clarkewayne/FHIRM-TPM-2.0-technical-documents/files/Assemble_miniature microscope.STEP

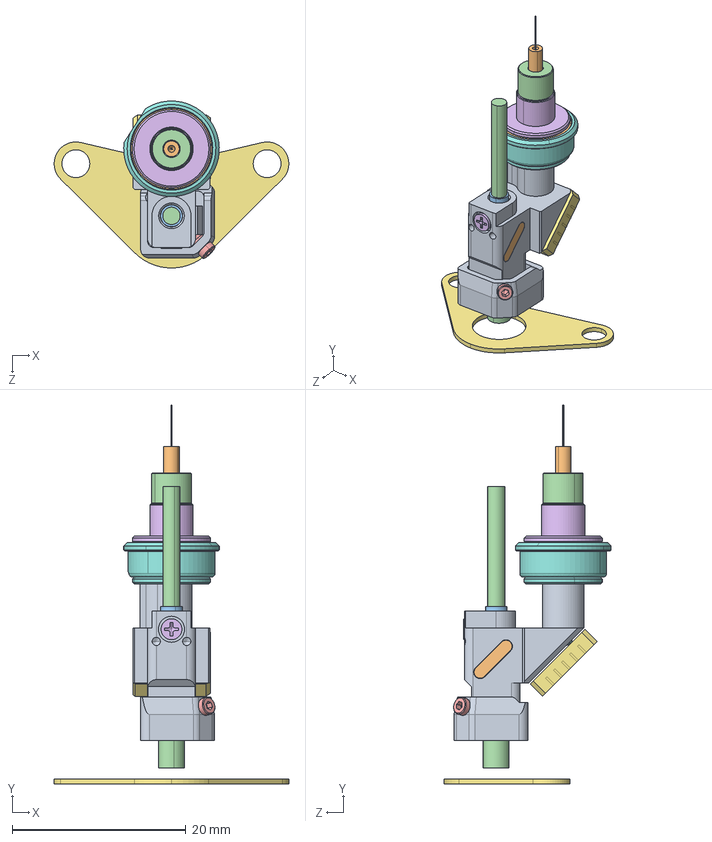
[picture p1: CAD file, 2020-08-04]
files/Assemble_miniature microscope.STEP
27.0 x 43.6 x 19.2 mm
1_Main_frame
2_Fiber_holder
3_Collimator_holder
4_HC-920 Fiber
6_MEMS
7_Scan lens
8_DM
9_Objective
10_Ring
11_EL-3-10 top holder
12_EL-3-10
13_EL-3-10 bottom holder
14_Holder
15_Cover
16_Optical fiber
17_Screw1
18_Screw2
19_Mouse baseplate
