clarkewayne/FHIRM-TPM-2.0-technical-documents/files/1_Main_frame.STEP

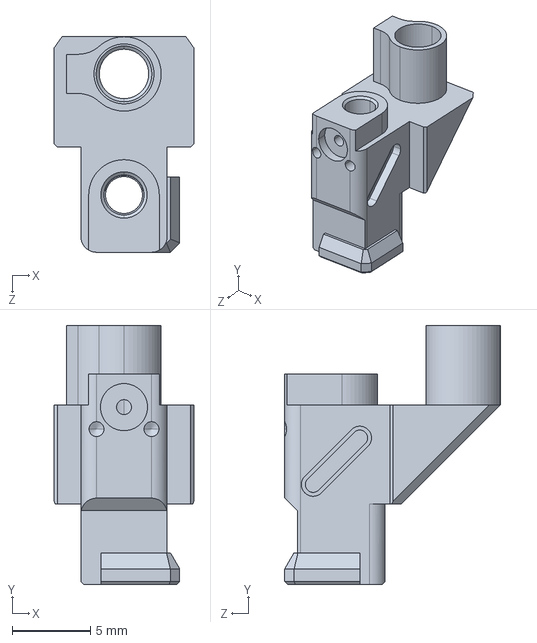
[picture p2: CAD file, 2020-08-04]
files/1_Main_frame.STEP
8.90 x 16.5 x 13.7 mm
