clarkewayne/FHIRM-TPM-2.0-technical-documents/Technical source file of the miniature microscope/20_84127.STEP

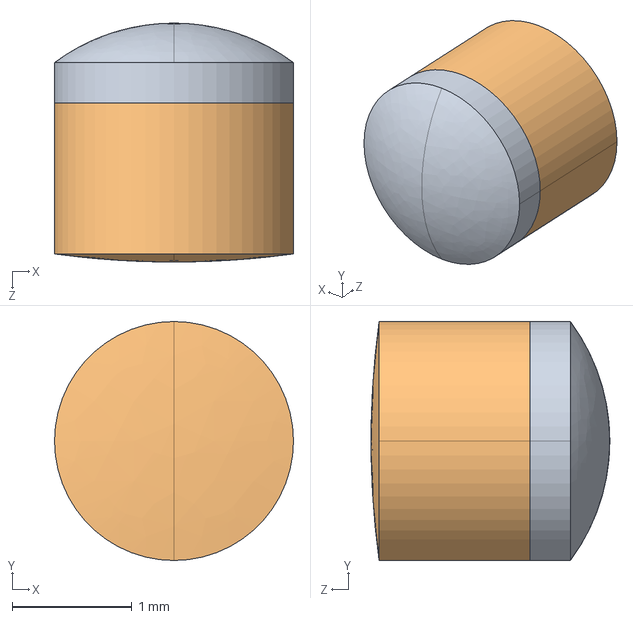
[picture p3: CAD file, 2020-08-04]
Technical source file of the miniature microscope/20_84127.STEP
2.00 x 2.00 x 2.00 mm
