clarkewayne/FHIRM-TPM-2.0-technical-documents/files/15_Cover.STEP

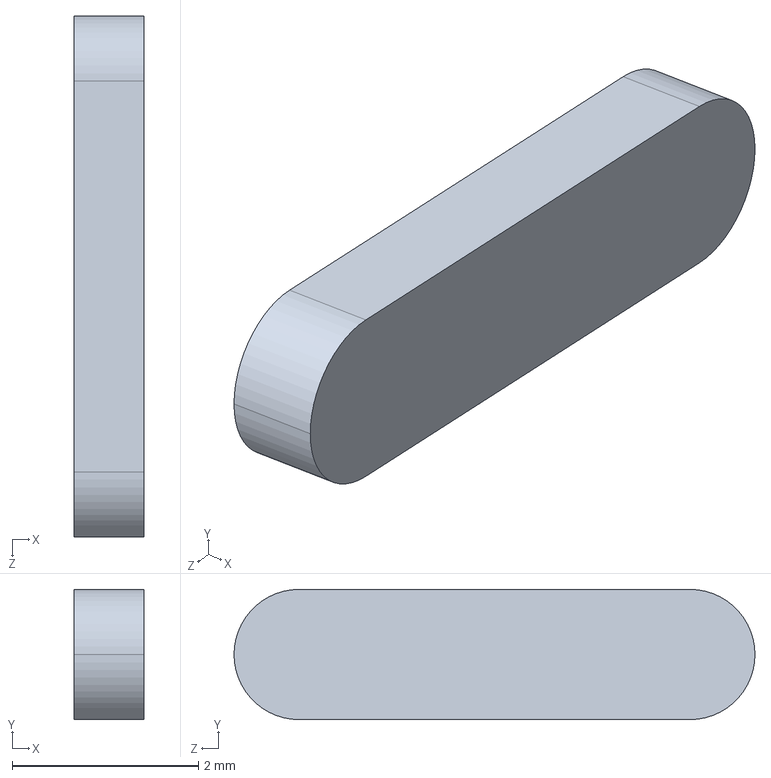
[picture p4: CAD file, 2020-08-04]
files/15_Cover.STEP
0.75 x 1.40 x 5.60 mm
