clarkewayne/FHIRM-TPM-2.0-technical-documents/Technical source file of the miniature microscope/3_Collimator_holder.STEP

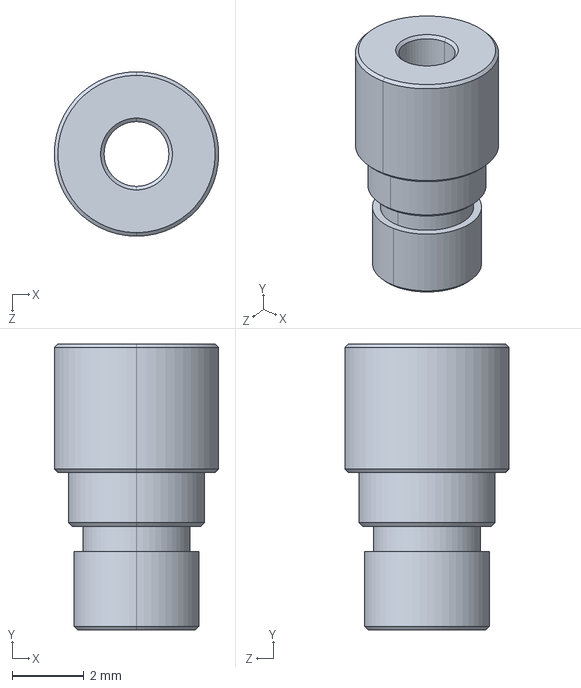
[picture p5: CAD file, 2020-08-04]
Technical source file of the miniature microscope/3_Collimator_holder.STEP
4.60 x 8.00 x 4.60 mm
