clarkewayne/FHIRM-TPM-2.0-technical-documents/Technical source file of the miniature microscope/2_Fiber_holder.STEP

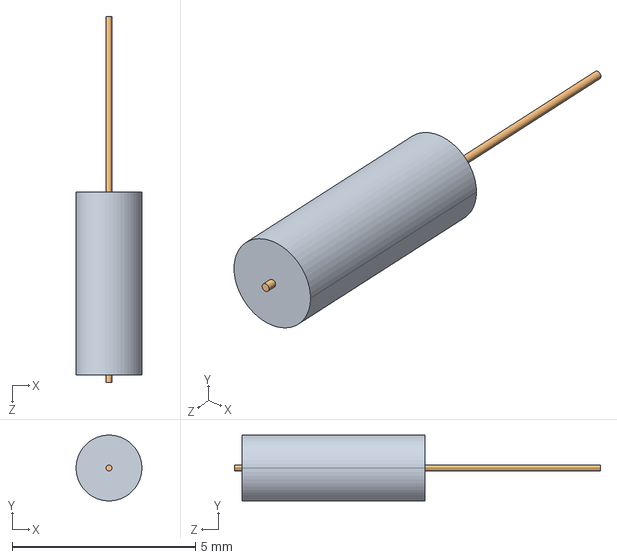
[picture p7: CAD file, 2020-08-04]
Technical source file of the miniature microscope/2_Fiber_holder.STEP
1.80 x 1.80 x 10.0 mm
