clarkewayne/FHIRM-TPM-2.0-technical-documents/files/9_Objective.STEP

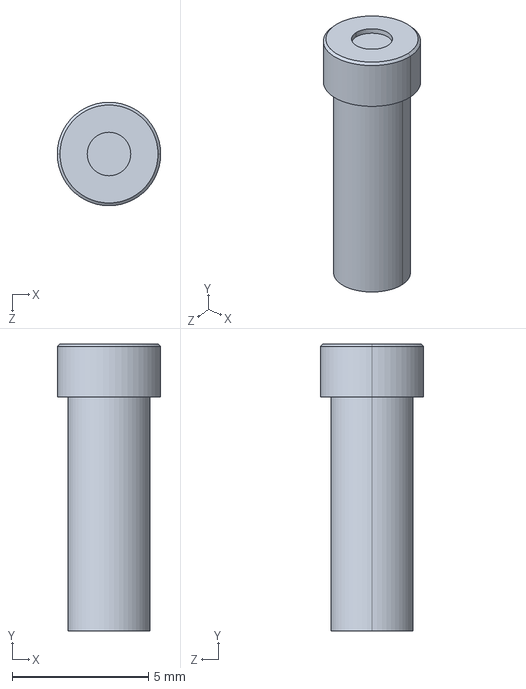
[picture p8: CAD file, 2020-08-04]
files/9_Objective.STEP
3.80 x 10.5 x 3.80 mm
