clarkewayne/FHIRM-TPM-2.0-technical-documents/files/12_EL-3-10.STEP

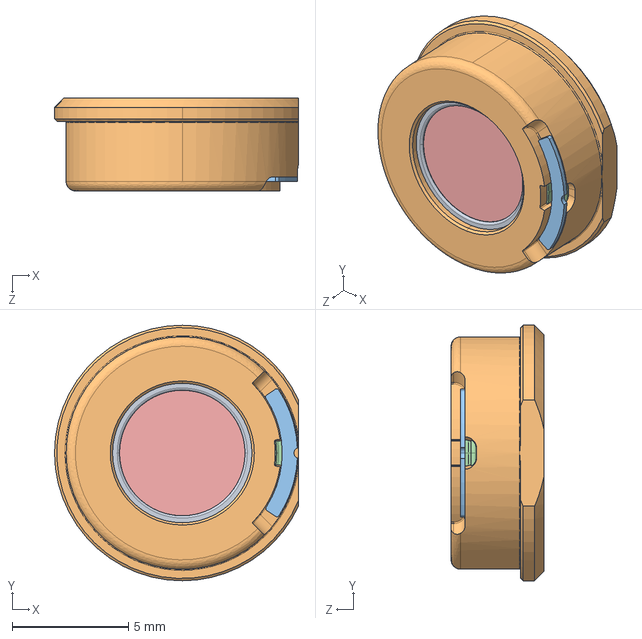
[picture p9: CAD file, 2020-08-04]
files/12_EL-3-10.STEP
10.5 x 11.0 x 4.00 mm
