clarkewayne/FHIRM-TPM-2.0-technical-documents/Technical source file of the miniature microscope/7_Scan lens.STEP

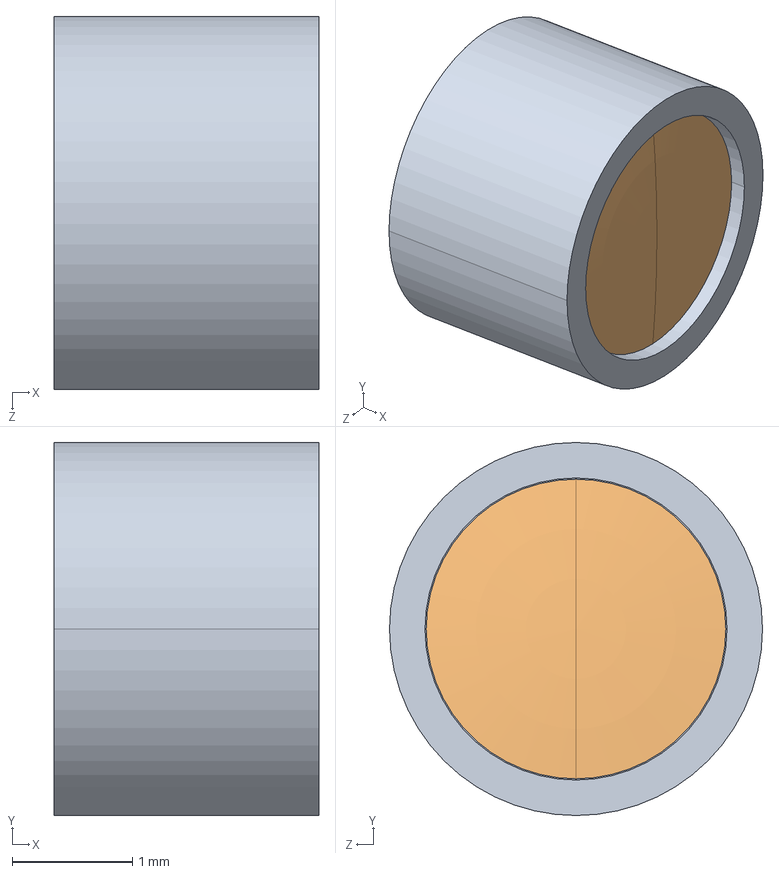
[picture p10: CAD file, 2020-08-04]
Technical source file of the miniature microscope/7_Scan lens.STEP
2.20 x 3.10 x 3.10 mm
