clarkewayne/FHIRM-TPM-2.0-technical-documents/Technical source file of the miniature microscope/19_Mouse baseplate.STEP

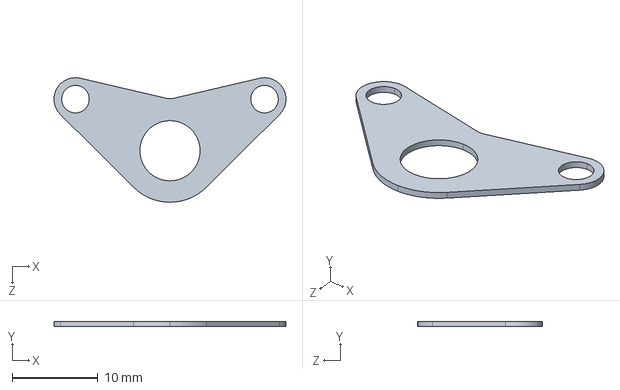
[picture p11: CAD file, 2020-08-04]
Technical source file of the miniature microscope/19_Mouse baseplate.STEP
27.0 x 0.6 x 14.5 mm
