clarkewayne/FHIRM-TPM-2.0-technical-documents/Technical source file of the miniature microscope/10_Ring.STEP

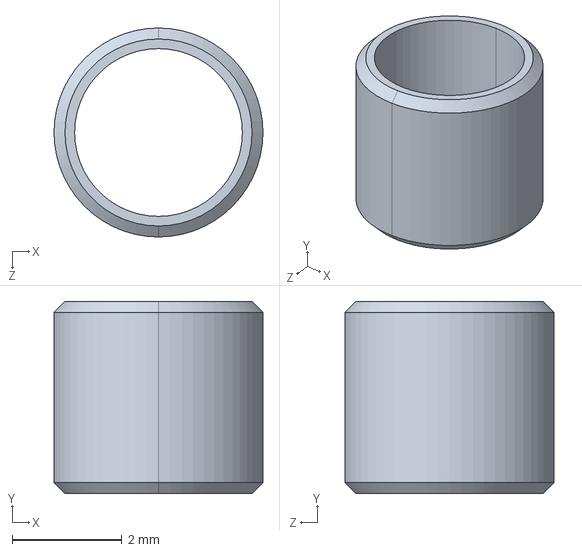
[picture p12: CAD file, 2020-08-04]
Technical source file of the miniature microscope/10_Ring.STEP
3.80 x 3.50 x 3.80 mm
