clarkewayne/FHIRM-TPM-2.0-technical-documents/Technical source file of the miniature microscope/6_MEMS.STEP

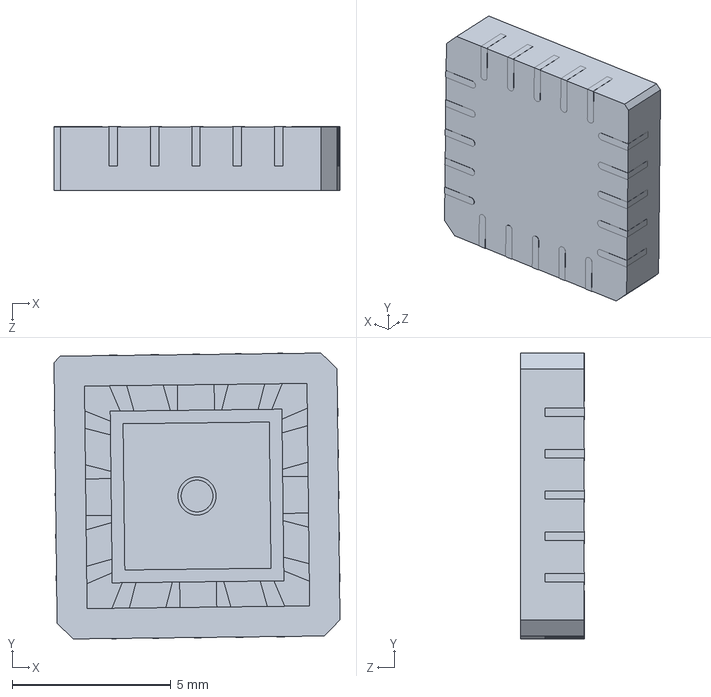
[picture p13: CAD file, 2020-08-04]
Technical source file of the miniature microscope/6_MEMS.STEP
9.00 x 8.99 x 2.01 mm
