clarkewayne/FHIRM-TPM-2.0-technical-documents/files/21_65270.stp

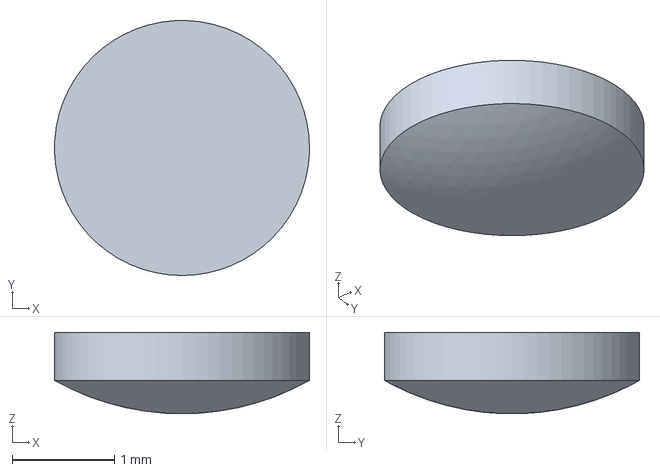
[picture p14: CAD file, 2020-08-04]
files/21_65270.stp
2.50 x 2.50 x 0.798 mm
