clarkewayne/FHIRM-TPM-2.0-technical-documents/files/8_DM.STEP

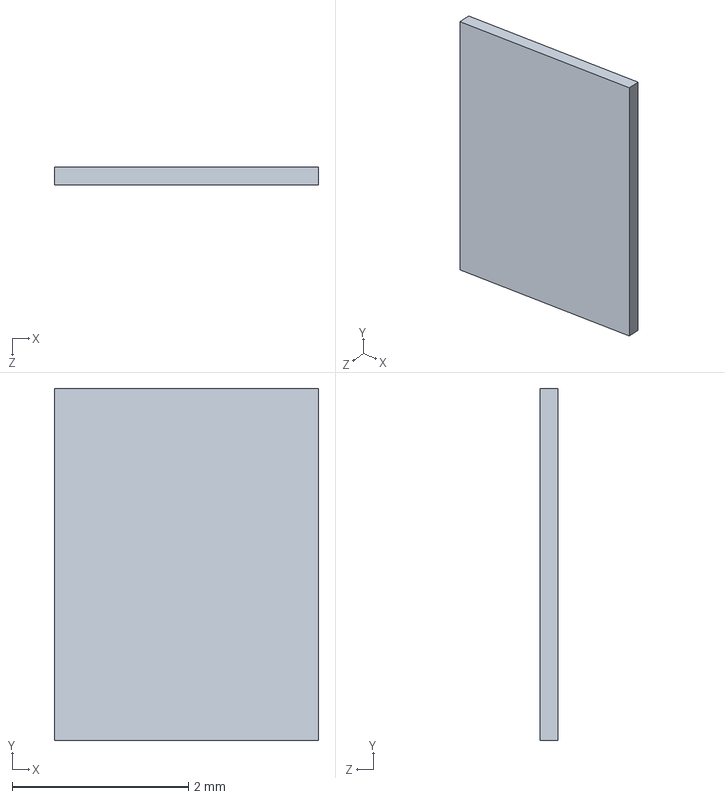
[picture p15: CAD file, 2020-08-04]
files/8_DM.STEP
3.00 x 4.00 x 0.2 mm
