clarkewayne/FHIRM-TPM-2.0-technical-documents/Technical source file of the miniature microscope/4_HC-920 Fiber.STEP

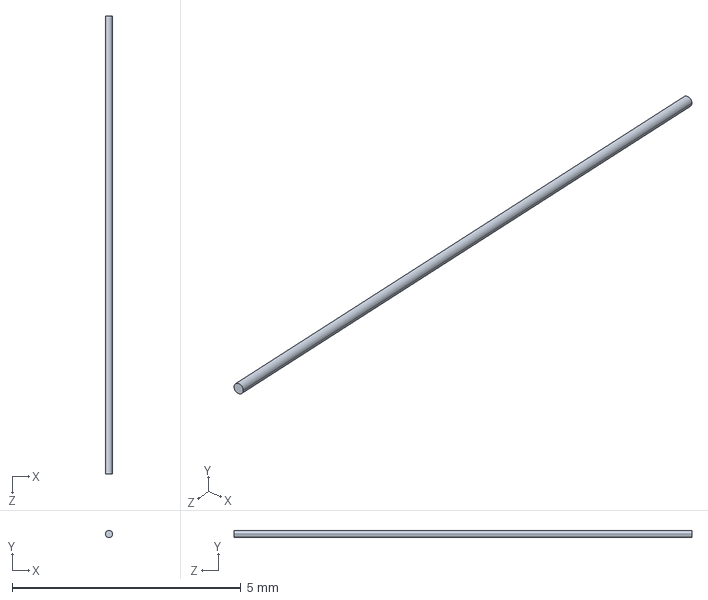
[picture p16: CAD file, 2020-08-04]
Technical source file of the miniature microscope/4_HC-920 Fiber.STEP
0.16 x 0.16 x 10.0 mm
