clarkewayne/FHIRM-TPM-2.0-technical-documents/files/14_Holder.STEP

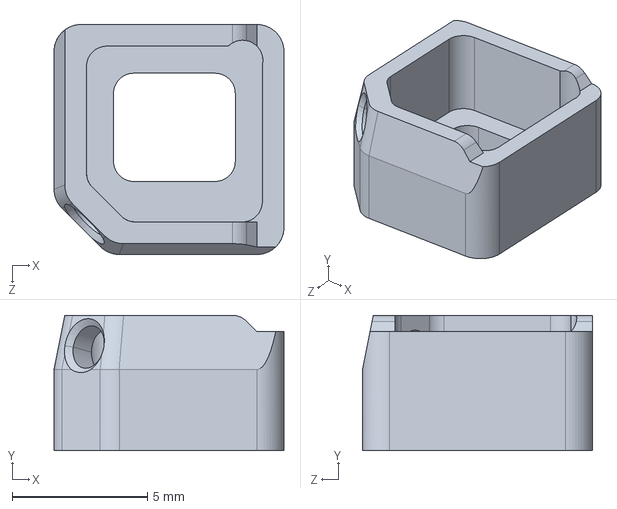
[picture p17: CAD file, 2020-08-04]
files/14_Holder.STEP
8.50 x 5.00 x 8.50 mm
