clarkewayne/FHIRM-TPM-2.0-technical-documents/Technical source file of the miniature microscope/13_EL-3-10 bottom holder.STEP

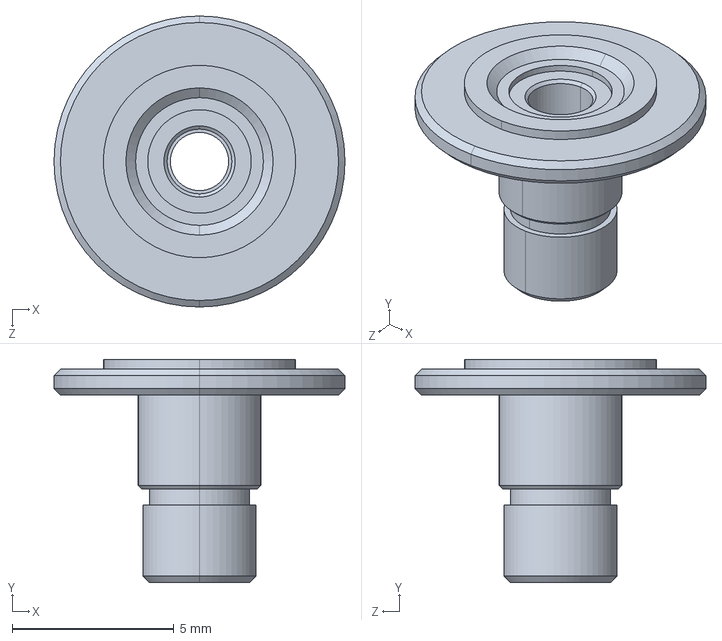
[picture p18: CAD file, 2020-08-04]
Technical source file of the miniature microscope/13_EL-3-10 bottom holder.STEP
9.00 x 6.90 x 9.00 mm
