clarkewayne/FHIRM-TPM-2.0-technical-documents/files/16_Optical fiber.STEP

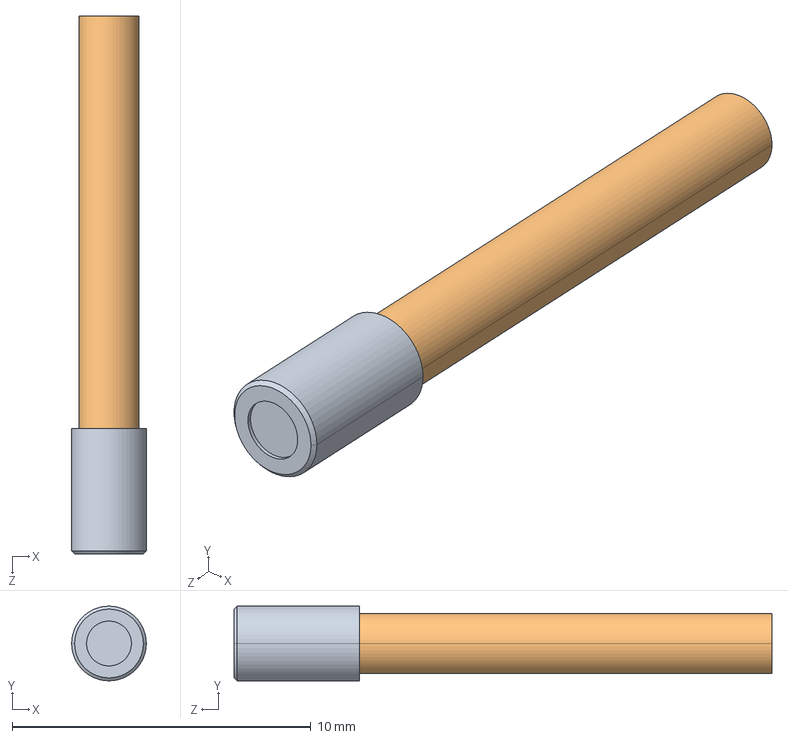
[picture p19: CAD file, 2020-08-04]
files/16_Optical fiber.STEP
2.50 x 2.50 x 18.0 mm
