clarkewayne/FHIRM-TPM-2.0-technical-documents/(list of files, cad)

Other CAD files:
Technical source file of the miniature microscope/5_84128.STEP
files/5_84128.STEP
Technical source file of the miniature microscope/17_Screw1.STEP
Technical source file of the miniature microscope/18_Screw2.STEP
files/17_Screw1.STEP
files/18_Screw2.STEP
