clarkewayne/FHIRM-TPM-2.0-technical-documents/Technical drawings of the miniature microscope/Assemble_miniature microscope.PDF

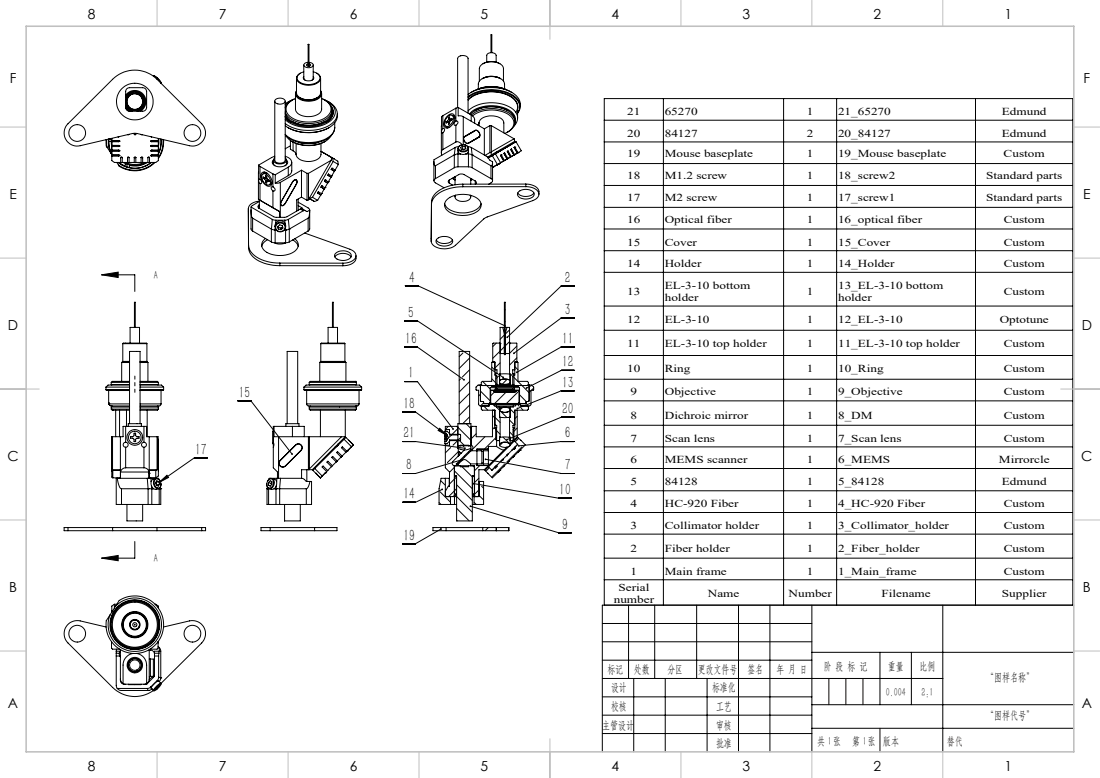
[picture p20: page 1]

21 | 65270 | 1 | 21_65270 | Edmund
20 | 84127 | 2 | 20_84127 | Edmund
19 | Mouse baseplate | 1 | 19_Mouse baseplate | Custom
18 | M1.2 screw | 1 | 18_screw2 | Standard parts
17 | M2 screw | 1 | 17_screw1 | Standard parts
16 | Optical fiber | 1 | 16_optical fiber | Custom
15 | Cover | 1 | 15_Cover | Custom
14 | Holder | 1 | 14_Holder | Custom
13 | EL-3-10 bottom holder | 1 | 13_EL-3-10 bottom holder | Custom

12 | EL-3-10 | 1 | 12_EL-3-10 | Optotune
11 | EL-3-10 top holder | 1 | 11_EL-3-10 top holder | Custom
10 | Ring | 1 | 10_Ring | Custom
9 | Objective | 1 | 9_Objective | Custom
8 | Dichroic mirror | 1 | 8_DM | Custom
7 | Scan lens | 1 | 7_Scan lens | Custom
6 | MEMS scanner | 1 | 6_MEMS | Mirrorcle
5 | 84128 | 1 | 5_84128 | Edmund
4 | HC-920 Fiber | 1 | 4_HC-920 Fiber | Custom
3 | Collimator holder | 1 | 3_Collimator_holder | Custom
2 | Fiber holder | 1 | 2_Fiber_holder | Custom
1 | Main frame | 1 | 1_Main_frame | Custom
Serial number | Name | Number | Filename | Supplier

阶 段 标 记 | 重量 | 比例 | “图样名称”

标记 | 处数 | 分区 | 更改文件号 | 签名 | 年 月 日
设计 | | | 标准化 | | | 0.004 | 2:1
校核 | | | 工艺
主管设计 | | | 审核

“图样代号”
