clarkewayne/FHIRM-TPM-2.0-technical-documents/Technical drawings of the miniature microscope/12_EL-3-10.PDF

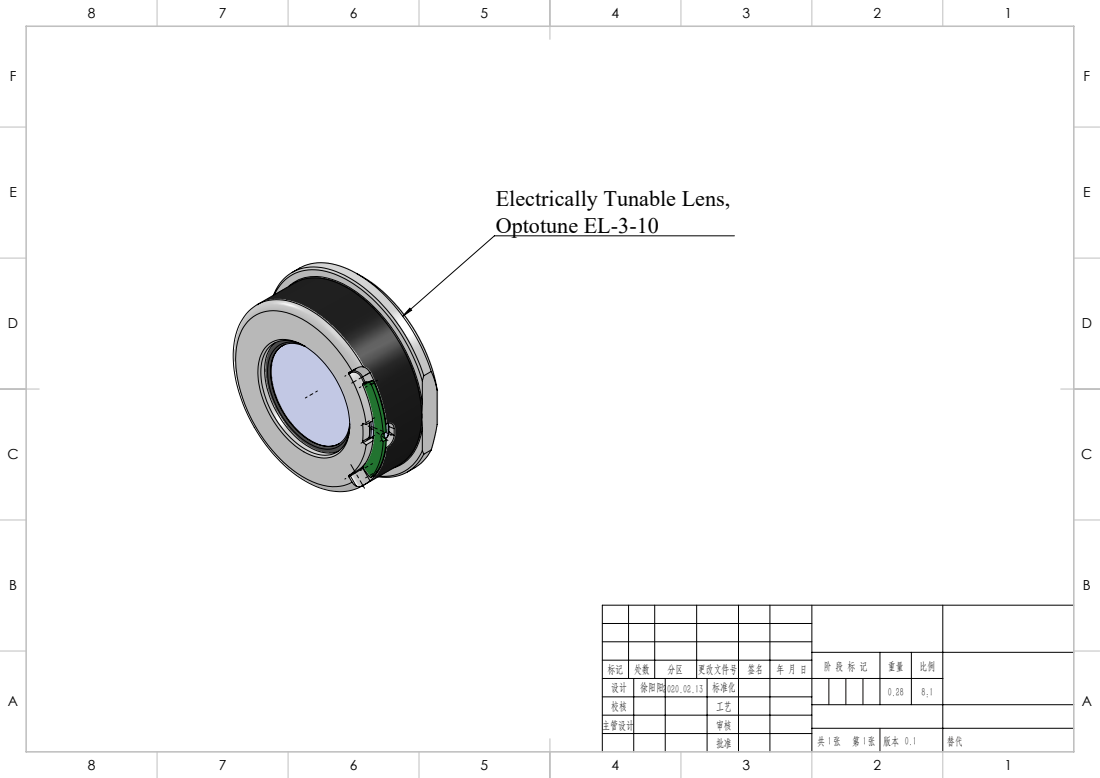
[picture p21: page 1]

Electrically Tunable Lens,
Optotune EL-3-10

标记 | 处数 | 分区 | 更改文件号 | 签名 | 年 月 日
设计 | 徐阳阳2020.02.13 | | 标准化 | | | 0.28 | 8:1
校核 | | | 工艺
主管设计 | | | 审核
