clarkewayne/FHIRM-TPM-2.0-technical-documents/Technical drawings of the miniature microscope/17_Screw1.PDF

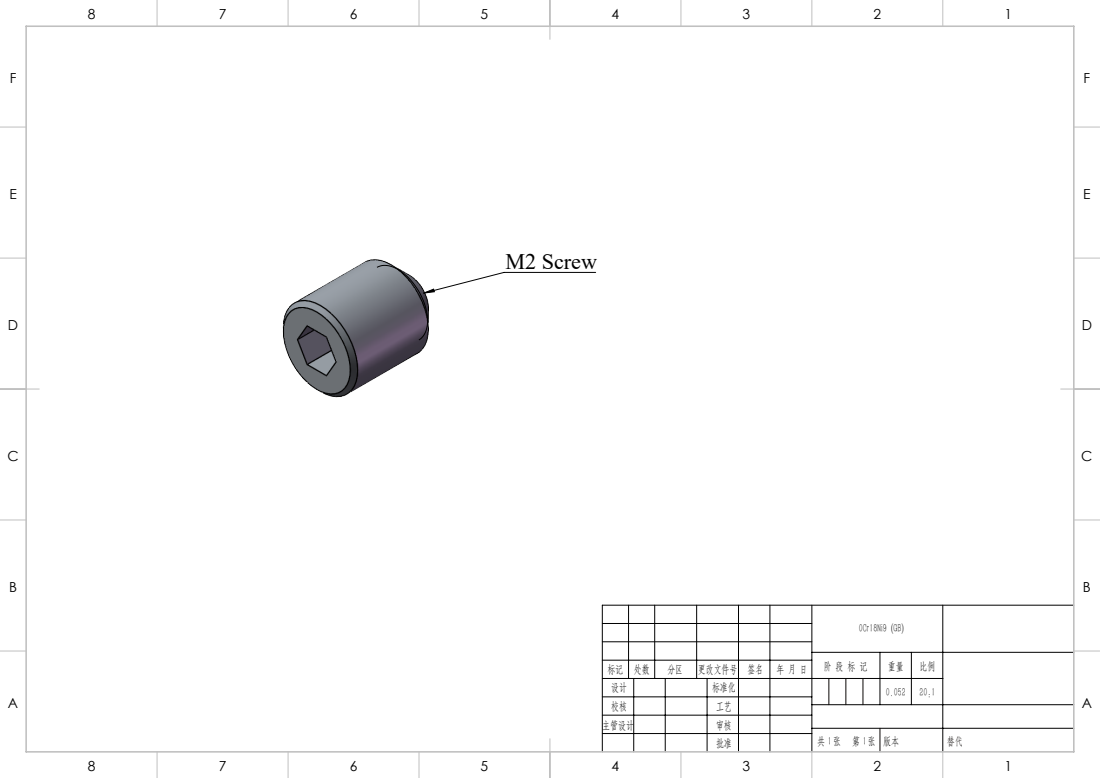
[picture p22: page 1]
M2 Screw

标记 | 处数 | 分区 | 更改文件号 | 签名 | 年 月 日
设计 | | | 标准化 | | | 0.052 | 20:1
校核 | | | 工艺
主管设计 | | | 审核
