clarkewayne/FHIRM-TPM-2.0-technical-documents/Technical drawings of the miniature microscope/18_Screw2.PDF

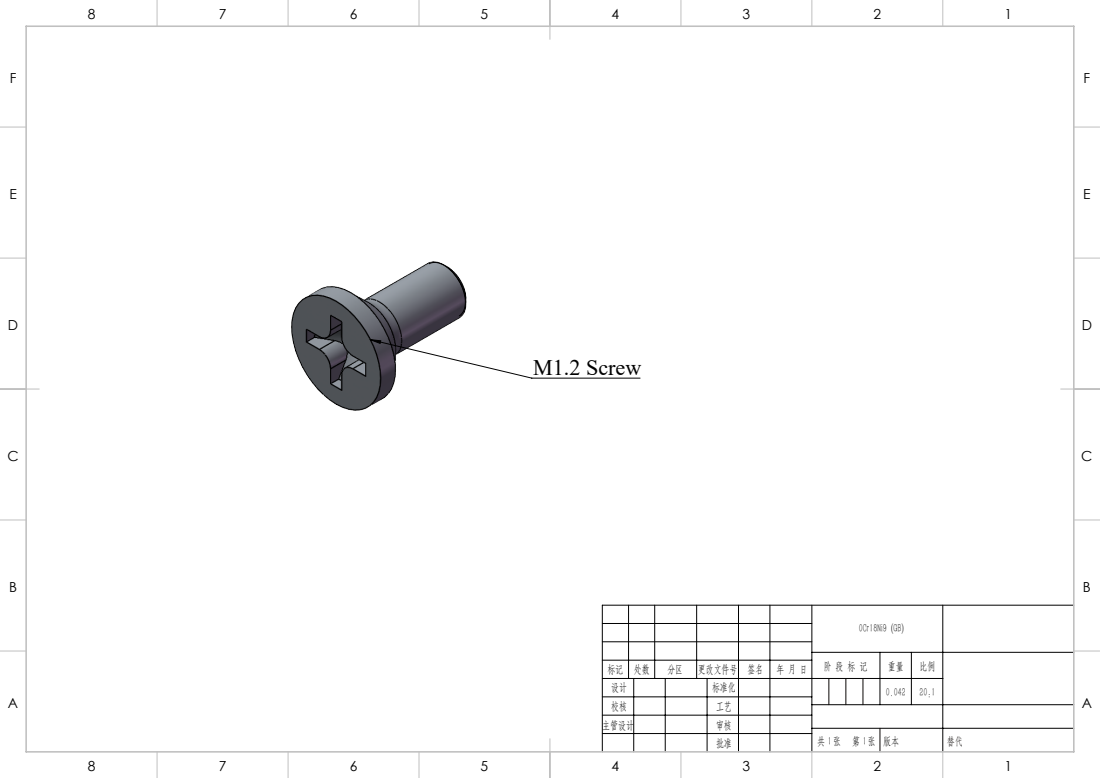
[picture p23: page 1]
M1.2 Screw

标记 | 处数 | 分区 | 更改文件号 | 签名 | 年 月 日
设计 | | | 标准化 | | | 0.042 | 20:1
校核 | | | 工艺
主管设计 | | | 审核
