clarkewayne/FHIRM-TPM-2.0-technical-documents/Technical drawings of the miniature microscope/21_65270.pdf

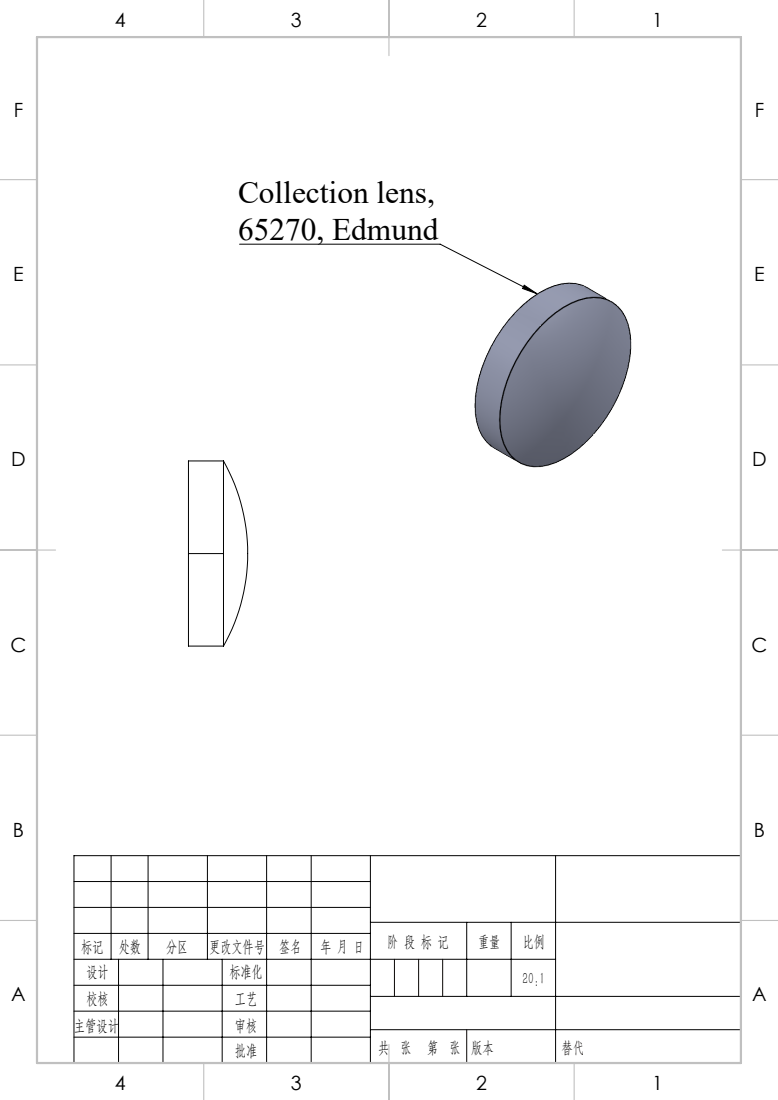
[picture p24: page 1]
Collection lens, 65270, Edmund

标记 | 处数 | 分区 | 更改文件号 | 签名 | 年 月 日
设计 | | | 标准化 | | | 20:1
校核 | | | 工艺
主管设计 | | | 审核
