clarkewayne/FHIRM-TPM-2.0-technical-documents/Technical drawings of the miniature microscope/2_Fiber_holder.PDF

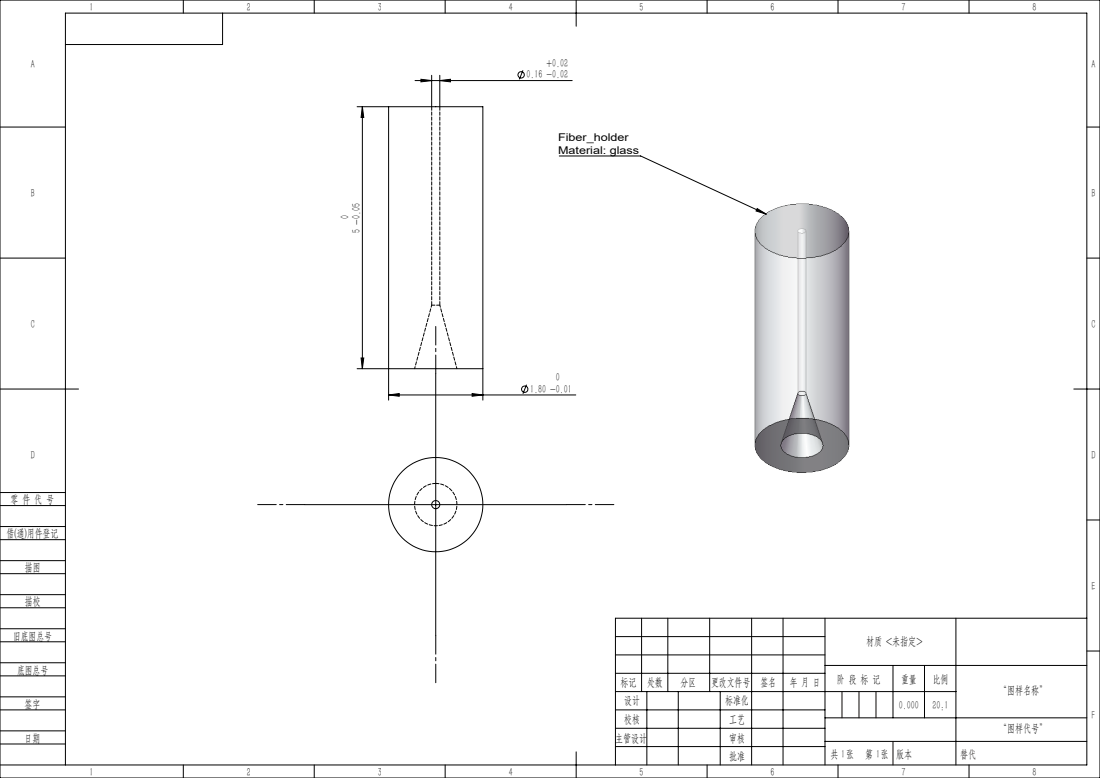
[picture p25: page 1]
Material: glass

材质 <未指定>

阶 段 标 记 | 重量 | 比例 | “图样名称”

标记 | 处数 | 分区 | 更改文件号 | 签名 | 年 月 日
设计 | | | 标准化 | | | | | 0.000 | 20:1
校核 | | | 工艺
主管设计 | | | 审核

“图样代号”
