clarkewayne/FHIRM-TPM-2.0-technical-documents/Technical drawings of the miniature microscope/9_Objective.PDF

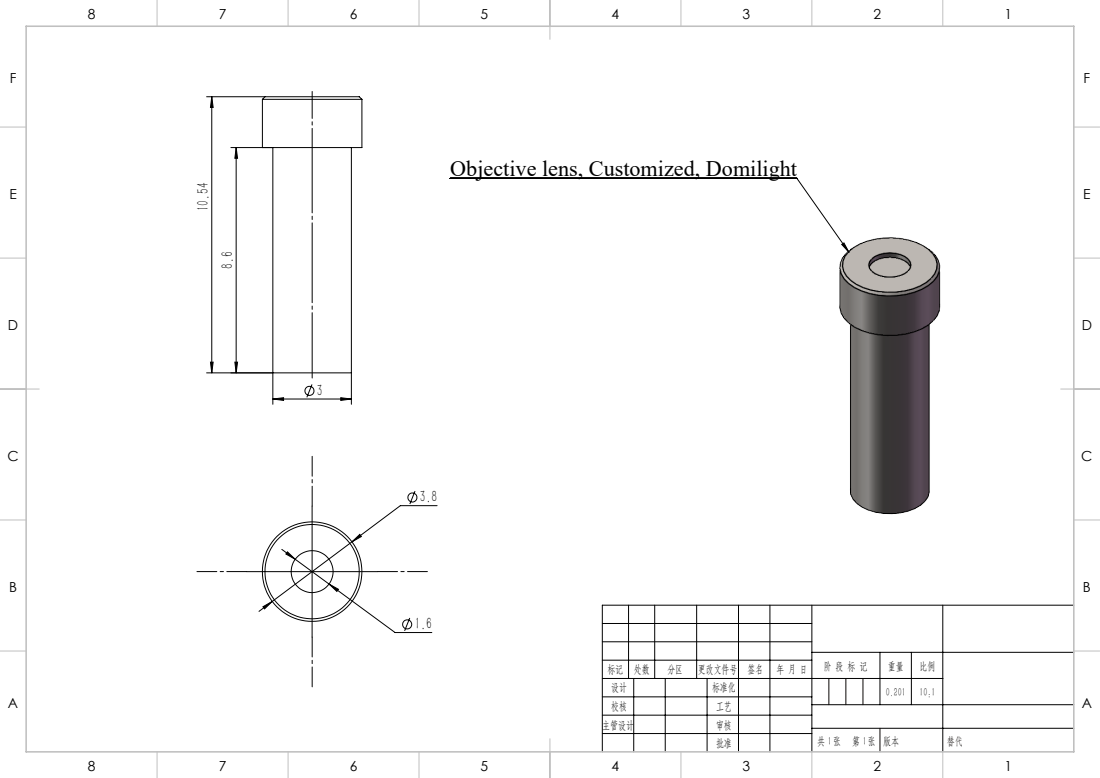
[picture p27: page 1]

Objective lens, Customized, Domilight

标记 | 处数 | 分区 | 更改文件号 | 签名 | 年 月 日
设计 | | | 标准化 | | | 0.201 | 10:1
校核 | | | 工艺
主管设计 | | | 审核
