clarkewayne/FHIRM-TPM-2.0-technical-documents/Technical drawings of the miniature microscope/10_Ring.PDF

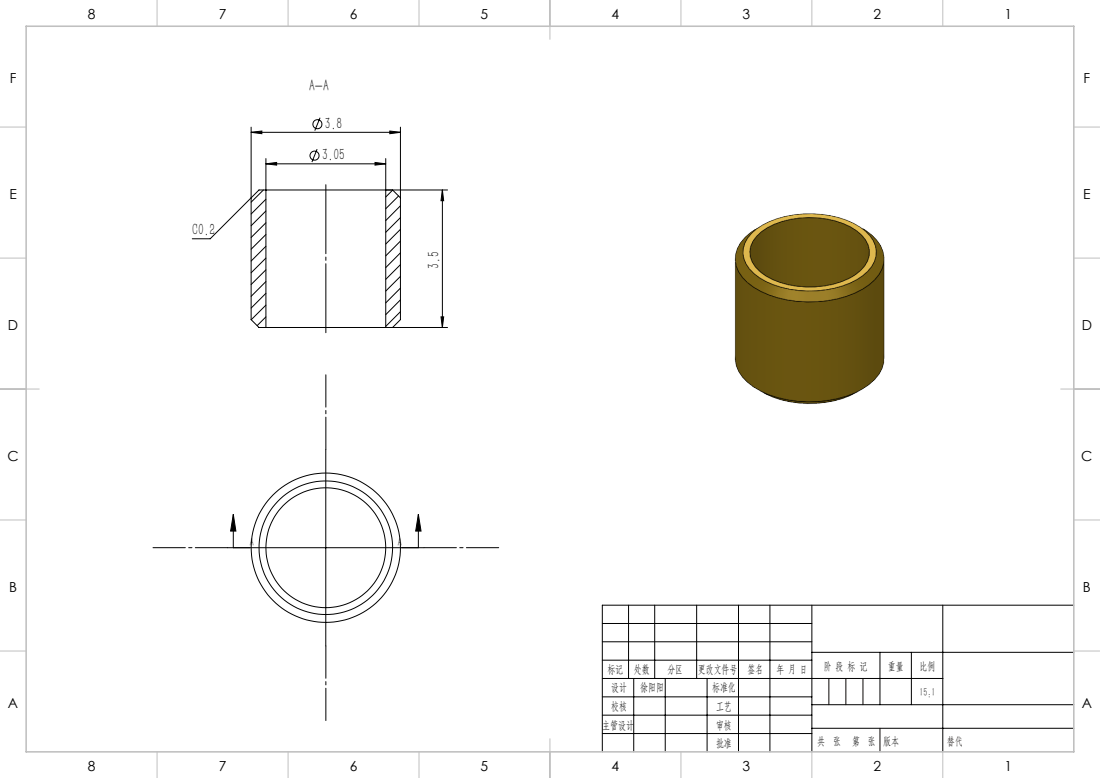
[picture p29: page 1]

标记 | 处数 | 分区 | 更改文件号 | 签名 | 年 月 日
设计 | 徐阳阳 | | 标准化 | | | 15:1
校核 | | | 工艺
主管设计 | | | 审核
