clarkewayne/FHIRM-TPM-2.0-technical-documents/Technical drawings of the miniature microscope/1_Main_frame.PDF

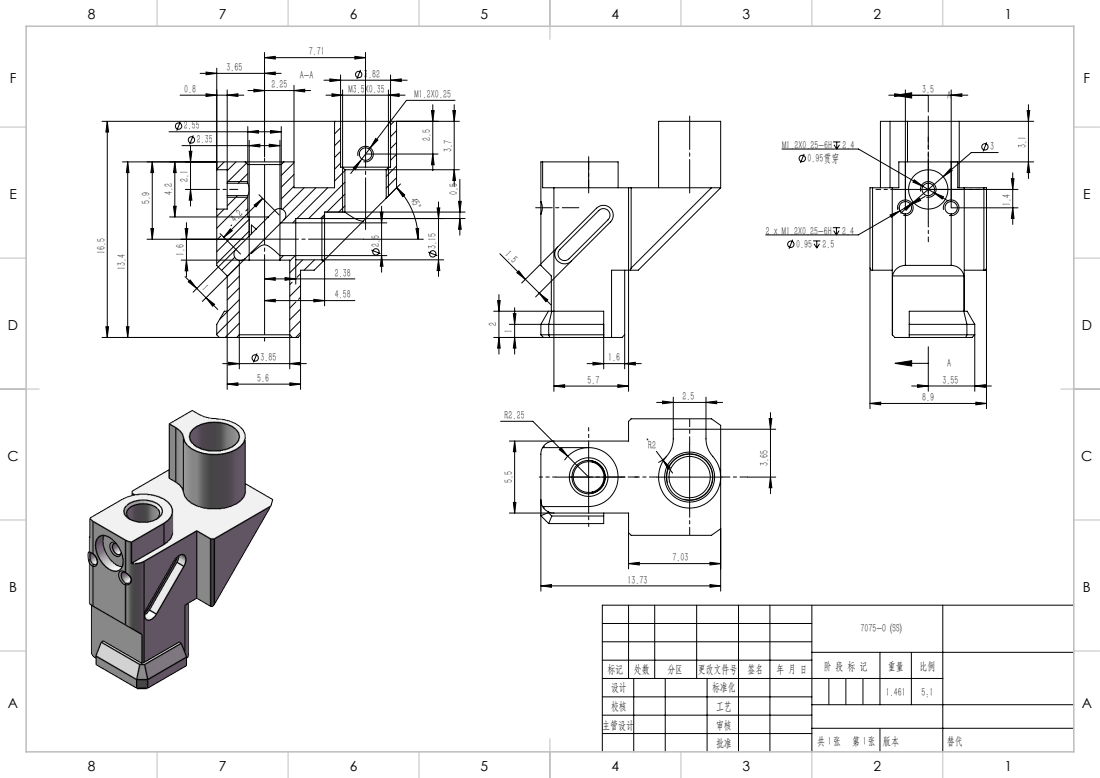
[picture p35: page 1]

标记 | 处数 | 分区 | 更改文件号 | 签名 | 年 月 日
设计 | | | 标准化 | | | 1.461 | 5:1
校核 | | | 工艺
主管设计 | | | 审核
