clarkewayne/FHIRM-TPM-2.0-technical-documents/Technical drawings of the miniature microscope/6_MEMS.PDF

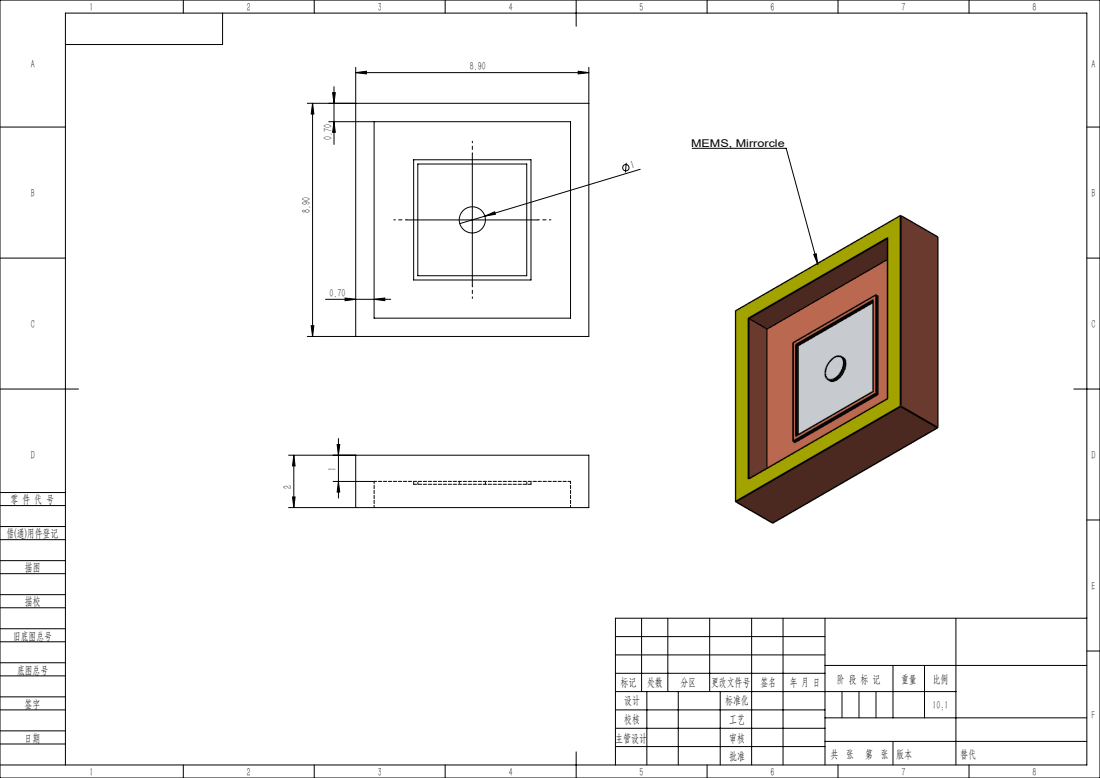
[picture p38: page 1]
MEMS, Mirrorcle

标记 | 处数 | 分区 | 更改文件号 | 签名 | 年 月 日
设计 | | | 标准化 | | | | | 10:1
校核 | | | 工艺
主管设计 | | | 审核
