clarkewayne/FHIRM-TPM-2.0-technical-documents/(commit log)

2020-08-04 0804 change
    [10_Ring.STEP, 11_EL-3-10 top holder.STEP, 12_EL-3-10.STEP, 13_EL-3-10 bottom holder.STEP, 14_Holder.STEP, 15_Cover.STEP, 16_Optical fiber.STEP, 17_Screw1.STEP]
2020-08-04 little change
    [10_Ring.STEP, 11_EL-3-10 top holder.STEP, 12_EL-3-10.STEP, 13_EL-3-10 bottom holder.STEP, 14_Holder.STEP, 15_Cover.STEP, 16_Optical fiber.STEP, 17_Screw1.STEP]
